adambujak/FALCON/README.md

FALCON

# An attempt at making drone
With Devin Bell ([@devinbellll](https://github.com/devinbellll) - Western University - Mechatronics Engineering) he's working on the flight controller, and I'm doing the RF, hardware, general bringup
