adambujak/FALCON/dependencies/gcc/README.md

# Config

Include GNU ARM toolchain (9-2020-q2-update version) in this folder, in subfolder ./gcc-arm-none-eabi-9-2020-q2-update
