adambujak/FALCON/hardware/pcb/hedwig/board.png

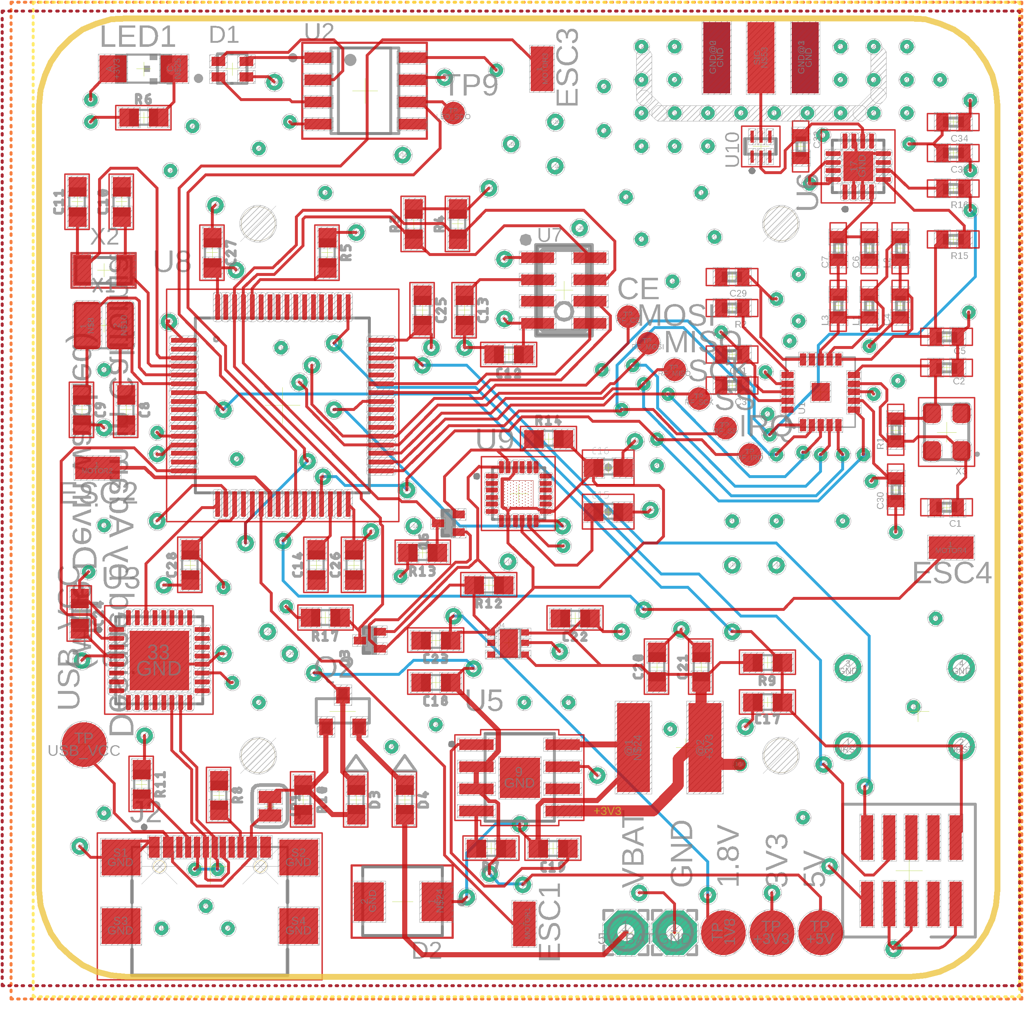
hardware/pcb/hedwig/board.png
