adambujak/FALCON/hardware/pcb/hedwig/board_bottom.png

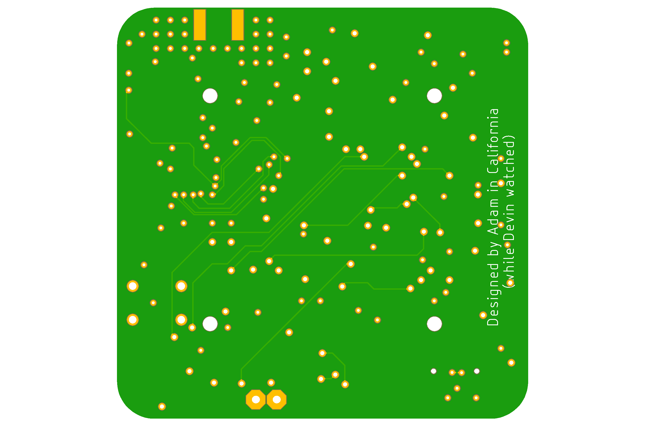
hardware/pcb/hedwig/board_bottom.png
