adambujak/FALCON/hardware/pcb/hedwig/board_top.png

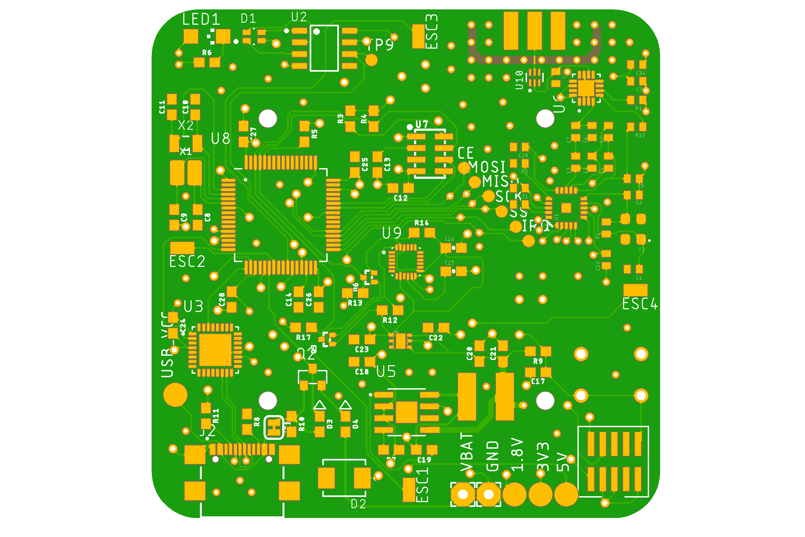
hardware/pcb/hedwig/board_top.png
