adambujak/FALCON/development/mechanicals/Part2.stl

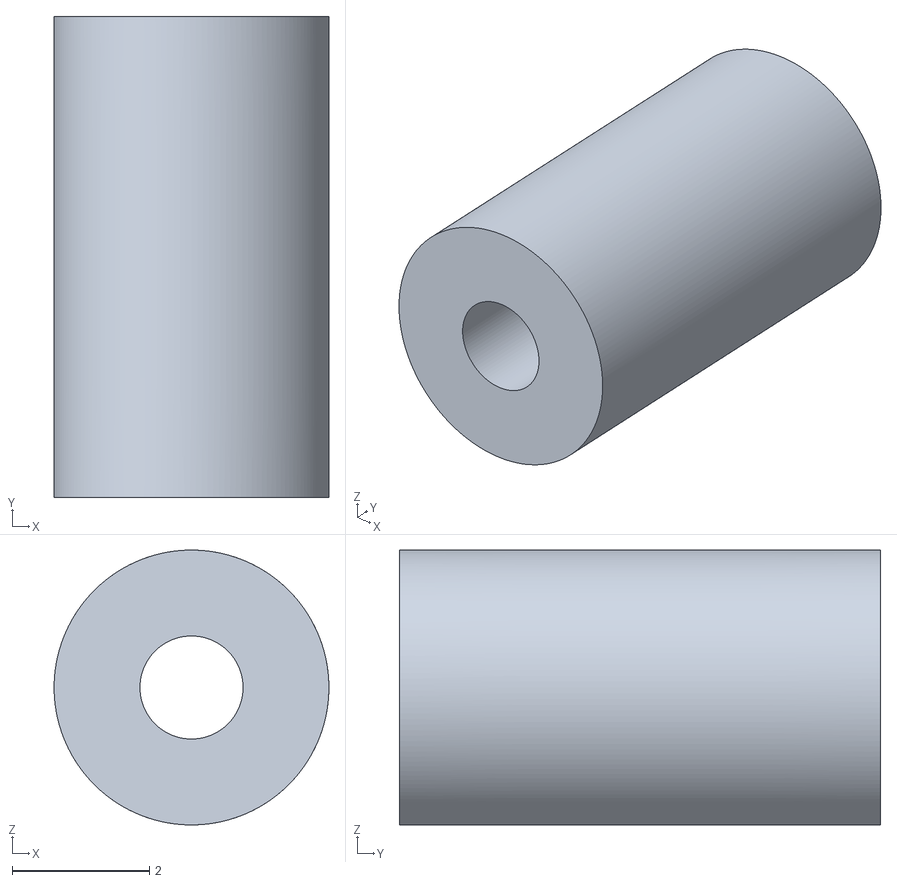
[picture p5: CAD file, 2020-04-04]
development/mechanicals/Part2.stl
4.00 x 7.00 x 4.00
