adambujak/FALCON/(list of files, cad)

Other CAD files:
development/mechanicals/motorconnector.ipt
development/mechanicals/motorholder-nocurvature.ipt
development/mechanicals/motorholder.ipt
