adambujak/FALCON/(threads)

Thread 59 (2021-04-18):

power supply browning out

adambujak, 2021-04-18:
radio failures due to power supply browning out

Thread 60 (2021-04-18):

python frame parsing

adambujak, 2021-04-18:
frame parsing doesn't work when serial monitor bufferflushcount is lowered.
either issue with how bytes are dropped in read thread or issue with frame parser

adambujak, 2021-04-20:
fixed

Closed 2021-04-20.

Thread 61 (2021-04-18):

flight control or sensor task starving device com

adambujak, 2021-04-18:
we start seeing tx failures from albus to hedwig when the flight control mode is set to 3

adambujak, 2021-04-19:
increasing device com priority does not solve issue

devinbellll, 2021-04-22:
what was the resolution to this issue?

adambujak, 2021-06-21:
I think this issue was due to higher current draw, and my 3.3V regulator not supplying it. But I'm not sure

devinbellll, 2022-11-22:
Please close out stale tickets with clear comments on how the issue was resolved

Thread 70 (2022-11-22):

Flight Control and Sensors Task starving eachother

adambujak, 2022-11-22:
If sensors task has higher priority, flight control task isn't executed with correct timing,
If flight control has higher priority, the `imu_get_data` function returns an error
