adambujak/FALCON/hardware/pcb/hedwig/hedwig.brd

## EAGLE design hardware/pcb/hedwig/hedwig.brd (2021-02-01)

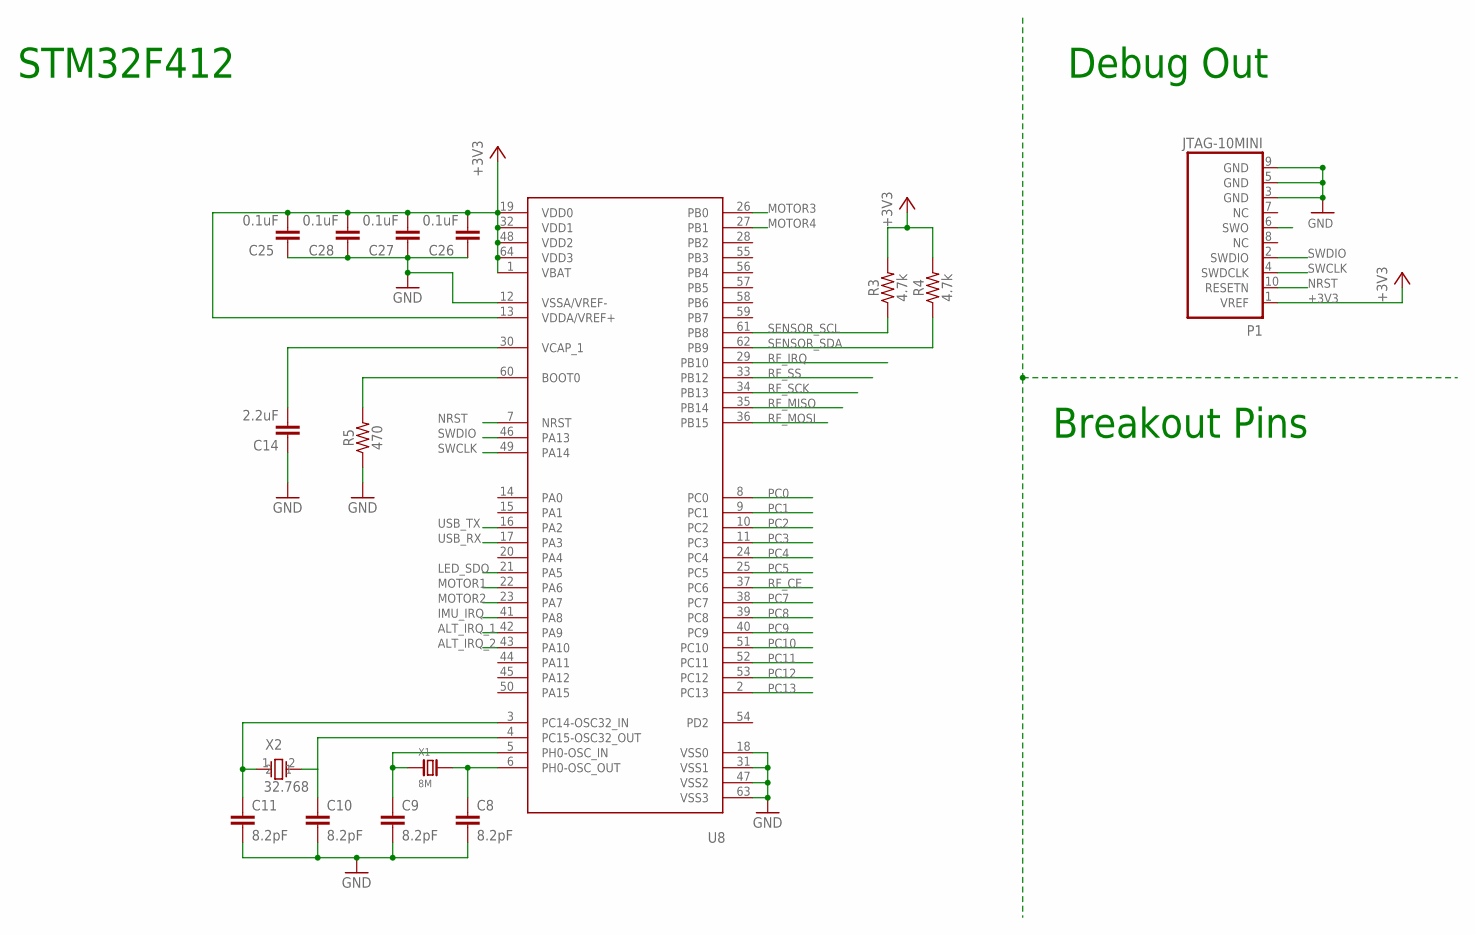
[picture p12: schematic hedwig.sch, sheet 1]

Parts:
C8, C9, C10, C11: 8.2pF; 0603
C14: 2.2uF; 0603
C25, C26, C27, C28: 0.1uF; 0603
P1: JTAG-10MINI
R3, R4: 4.7k; 0603
R5: 470; 0603
U8: STM32F412RE-S; QFP50P1200X1200X160-64N
X1: 8M; NDK-NX3225GD
X2: 32.768; NDK_NX3215SA-32.768K-STD-MUA-8_0

Connections:
+3V3: C25.2, C26.2, C27.2, C28.2, P1.1 (VREF), R3.2, R4.2, U8.1 (VBAT), U8.13 (VDDA/VREF+), U8.19 (VDD0), U8.32 (VDD1), U8.48 (VDD2), U8.64 (VDD3); also elsewhere on the board
ALT_IRQ_1: U8.42 (PA9); also elsewhere on the board
ALT_IRQ_2: U8.43 (PA10); also elsewhere on the board
GND: C8.2, C9.2, C10.2, C11.2, C14.1, C25.1, C26.1, C27.1, C28.1, P1.3 (GND), P1.5 (GND), P1.9 (GND), R5.1, U8.12 (VSSA/VREF-), U8.18 (VSS0), U8.31 (VSS1), U8.47 (VSS2), U8.63 (VSS3); also elsewhere on the board
IMU_IRQ: U8.41 (PA8); also elsewhere on the board
LED_SDO: U8.21 (PA5); also elsewhere on the board
MOTOR1: U8.22 (PA6); also elsewhere on the board
MOTOR2: U8.23 (PA7); also elsewhere on the board
MOTOR3: U8.26 (PB0); also elsewhere on the board
MOTOR4: U8.27 (PB1); also elsewhere on the board
unnamed: C9.1, U8.5 (PH0-OSC_IN), X1.1
unnamed: C8.1, U8.6 (PH0-OSC_OUT), X1.2
unnamed: C11.1, U8.3 (PC14-OSC32_IN), X2.1
unnamed: C10.1, U8.4 (PC15-OSC32_OUT), X2.2
unnamed: R5.2, U8.60 (BOOT0)
unnamed: C14.2, U8.30 (VCAP_1)
NRST: P1.10 (RESETN), U8.7 (NRST); also elsewhere on the board
PC0: U8.8 (PC0)
PC1: U8.9 (PC1)
PC2: U8.10 (PC2)
PC3: U8.11 (PC3)
PC4: U8.24 (PC4)
PC5: U8.25 (PC5)
PC7: U8.38 (PC7)
PC8: U8.39 (PC8)
PC9: U8.40 (PC9)
PC10: U8.51 (PC10)
PC11: U8.52 (PC11)
PC12: U8.53 (PC12)
PC13: U8.2 (PC13)
RF_CE: U8.37 (PC6); also elsewhere on the board
RF_IRQ: U8.29 (PB10); also elsewhere on the board
RF_MISO: U8.35 (PB14); also elsewhere on the board
RF_MOSI: U8.36 (PB15); also elsewhere on the board
RF_SCK: U8.34 (PB13); also elsewhere on the board
RF_SS: U8.33 (PB12); also elsewhere on the board
SENSOR_SCL: R3.1, U8.61 (PB8); also elsewhere on the board
SENSOR_SDA: R4.1, U8.62 (PB9); also elsewhere on the board
SWCLK: P1.4 (SWDCLK), U8.49 (PA14)
SWDIO: P1.2 (SWDIO), U8.46 (PA13)
USB_RX: U8.17 (PA3); also elsewhere on the board
USB_TX: U8.16 (PA2); also elsewhere on the board

Notes on the sheet:
Breakout Pins
STM32F412
Debug Out

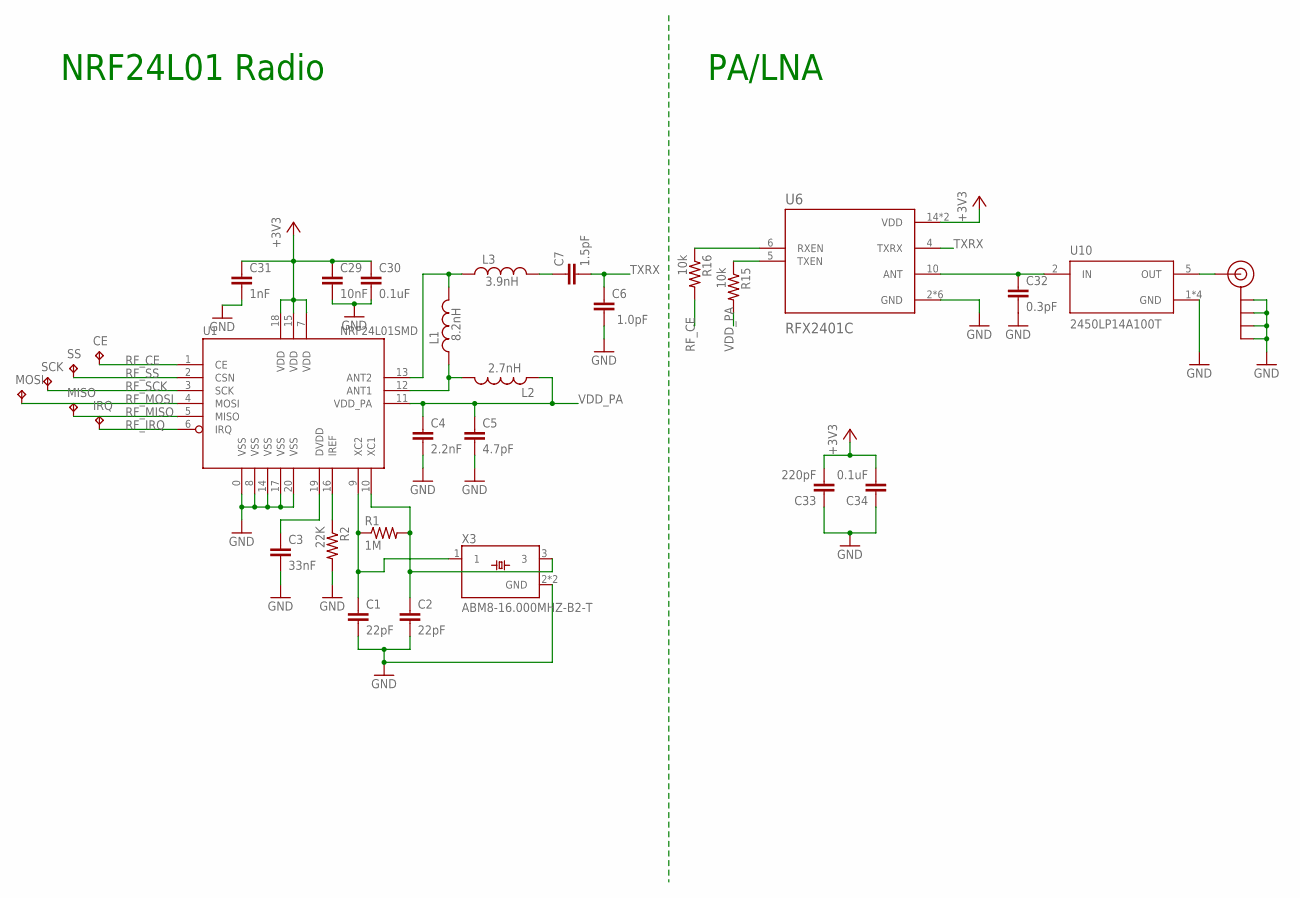
[picture p13: schematic hedwig.sch, sheet 2]

Parts:
C1, C2: 22pF; C0402
C3: 33nF; C0402
C4: 2.2nF; C0402
C5: 4.7pF; C0402
C6: 1.0pF; C0402
C7: 1.5pF; C0402
C29: 10nF; C0402
C30, C34: 0.1uF; C0402
C31: 1nF; C0402
C32: 0.3pF; C0402
C33: 220pF; C0402
CE: TPB1,27; B1,27
IRQ: TPB1,27; B1,27
J3: SMA_EDGE; SMA-EDGE
L1: 8.2nH; C0402
L2: 2.7nH; C0402
L3: 3.9nH; C0402
MISO: TPB1,27; B1,27
MOSI: TPB1,27; B1,27
R1: 1M; C0402
R2: 22K; C0402
R15, R16: 10k; C0402
SCK: TPB1,27; B1,27
SS: TPB1,27; B1,27
U1: NRF24L01SMD; QFN20
U6: RFX2401C; QFN50P300X300X60-17N
U10: 2450LP14A100T; ICCAF50P160X80X70-6N
X3: ABM8-16.000MHZ-B2-T; OSCSC320X250X100N

Connections:
+3V3: C29.1, C30.1, C31.1, C33.2, C34.2, U1.7 (VDD), U1.15 (VDD), U1.18 (VDD), U6.14 (VDD), U6.16 (VDD); also elsewhere on the board
GND: C1.2, C2.2, C3.2, C4.2, C5.2, C6.1, C29.2, C30.2, C31.2, C32.2, C33.1, C34.1, J3.GND@0 (GND), J3.GND@1 (GND), J3.GND@2 (GND), J3.GND@3 (GND), R2.2, U1.0 (VSS), U1.8 (VSS), U1.14 (VSS), U1.17 (VSS), U1.20 (VSS), U6.2 (GND), U6.3 (GND), U6.8 (GND), U6.9 (GND), U6.11 (GND), U6.17 (GND), U10.1 (GND), U10.3 (GND), U10.4 (GND), U10.6 (GND), X3.2 (GND), X3.4 (GND); also elsewhere on the board
unnamed: C1.1, R1.1, U1.9 (XC2), X3.1
unnamed: C2.1, R1.2, U1.10 (XC1), X3.3
unnamed: L1.1, L2.2, U1.12 (ANT1)
unnamed: R2.1, U1.16 (IREF)
unnamed: C3.1, U1.19 (DVDD)
unnamed: L1.2, L3.1, U1.13 (ANT2)
unnamed: C7.1, L3.2
unnamed: C32.1, U6.10 (ANT), U10.2 (IN)
unnamed: J3.SIG (SIGNAL), U10.5 (OUT)
unnamed: R16.1, U6.6 (RXEN)
unnamed: R15.1, U6.5 (TXEN)
RF_CE: CE.TP, R16.2, U1.1 (CE); also elsewhere on the board
RF_IRQ: IRQ.TP, U1.6 (IRQ); also elsewhere on the board
RF_MISO: MISO.TP, U1.5 (MISO); also elsewhere on the board
RF_MOSI: MOSI.TP, U1.4 (MOSI); also elsewhere on the board
RF_SCK: SCK.TP, U1.3 (SCK); also elsewhere on the board
RF_SS: SS.TP, U1.2 (CSN); also elsewhere on the board
TXRX: C6.2, C7.2, U6.4 (TXRX)
VDD_PA: C4.1, C5.1, L2.1, R15.2, U1.11 (VDD_PA)

Notes on the sheet:
NRF24L01 Radio
PA/LNA

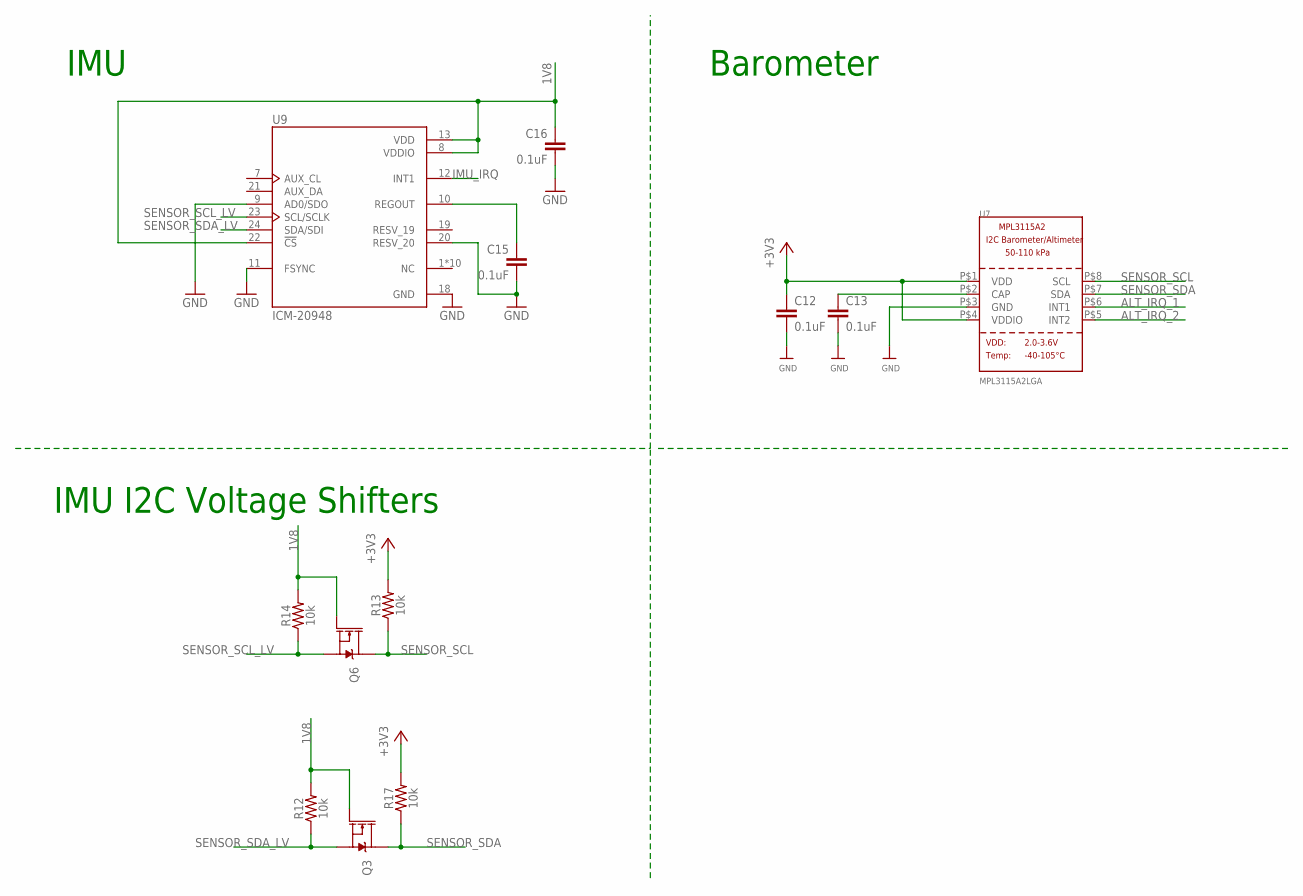
[picture p14: schematic hedwig.sch, sheet 3]

Parts:
C12, C13: 0.1uF; 0603
C15, C16: 0.1uF; 0603-CAP
Q3, Q6: 20V/0.2A/8MHz/1.2Ω/1Vth; SOT-416FL
R12, R13, R14, R17: 10k; 0603
U7: MPL3115A2LGA; LGA8
U9: ICM-20948; QFN40P300X300X105-24N

Connections:
1V8: C16.1, Q3.1 (G), Q6.1 (G), R12.2, R14.2, U9.8 (VDDIO), U9.13 (VDD), U9.22 (!CS); also elsewhere on the board
+3V3: C12.1, R13.2, R17.2, U7.P$1 (VDD), U7.P$4 (VDDIO); also elsewhere on the board
ALT_IRQ_1: U7.P$6 (INT1); also elsewhere on the board
ALT_IRQ_2: U7.P$5 (INT2); also elsewhere on the board
CAP: C13.1, U7.P$2 (CAP)
GND: C12.2, C13.2, C15.2, C16.2, U7.P$3 (GND), U9.9 (AD0/SDO), U9.11 (FSYNC), U9.18 (GND), U9.20 (RESV_20); also elsewhere on the board
IMU_IRQ: U9.12 (INT1); also elsewhere on the board
unnamed: C15.1, U9.10 (REGOUT)
SENSOR_SCL: Q6.3 (D), R13.1, U7.P$8 (SCL); also elsewhere on the board
SENSOR_SCL_LV: Q6.2 (S), R14.1, U9.23 (SCL/SCLK)
SENSOR_SDA: Q3.3 (D), R17.1, U7.P$7 (SDA); also elsewhere on the board
SENSOR_SDA_LV: Q3.2 (S), R12.1, U9.24 (SDA/SDI)

Notes on the sheet:
IMU
Barometer
IMU I2C Voltage Shifters

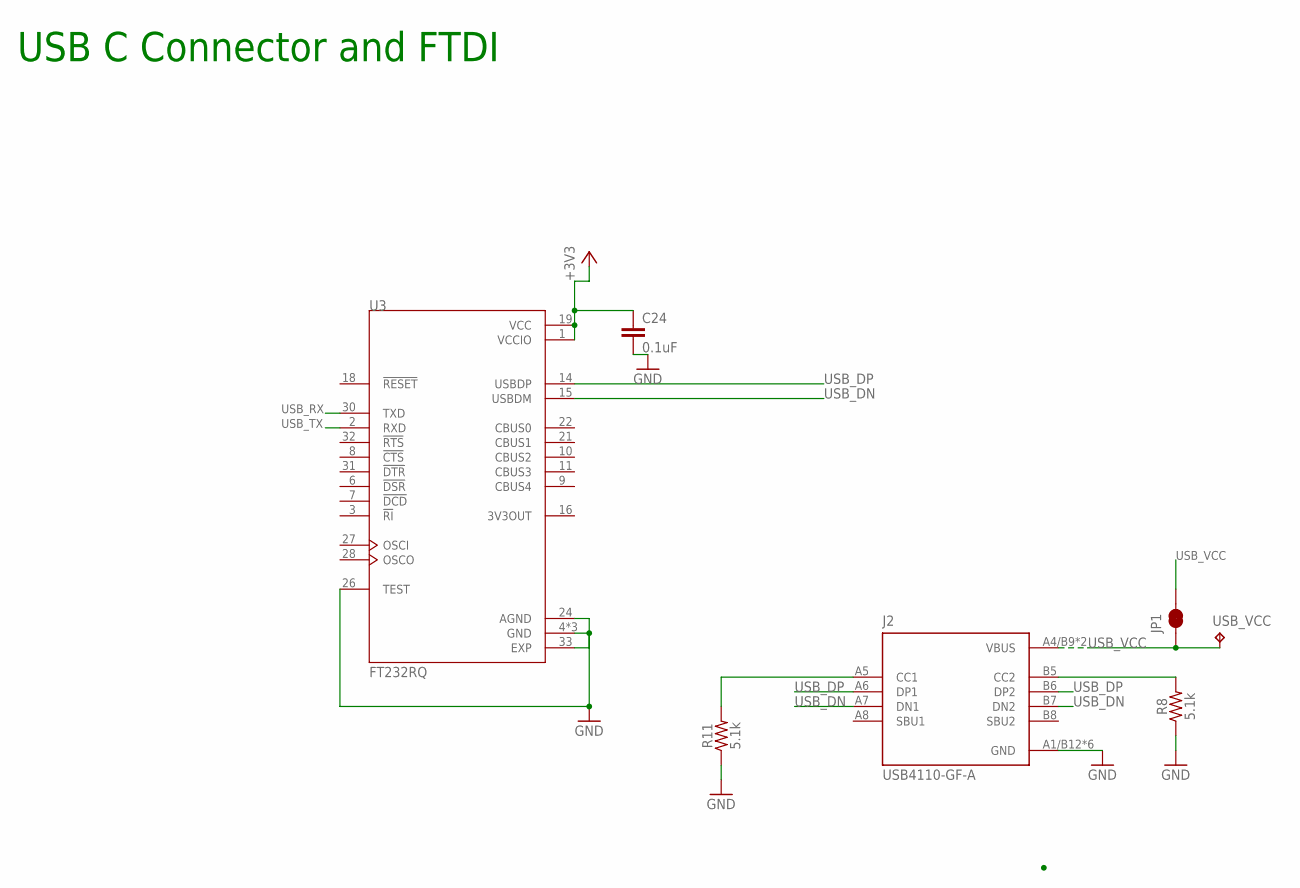
[picture p15: schematic hedwig.sch, sheet 4]

Parts:
C24: 0.1uF; 0603
J2: USB4110-GF-A; GCT_USB4110-GF-A
JP1: JUMPER-SMT_2_NC_TRACE_SILK; SMT-JUMPER_2_NC_TRACE_SILK
R8, R11: 5.1k; 0603
U3: FT232RQ; QFN50P500X500X90-33N
USB_VCC: TPB2,54; B2,54

Connections:
+3V3: C24.1, U3.1 (VCCIO), U3.19 (VCC); also elsewhere on the board
GND: C24.2, J2.A1/B12 (GND), J2.B1/A12 (GND), J2.S1 (GND), J2.S2 (GND), J2.S3 (GND), J2.S4 (GND), R8.1, R11.1, U3.4 (GND), U3.17 (GND), U3.20 (GND), U3.24 (AGND), U3.26 (TEST), U3.33 (EXP); also elsewhere on the board
unnamed: J2.B5 (CC2), R8.2
unnamed: J2.A5 (CC1), R11.2
USB_DN: J2.A7 (DN1), J2.B7 (DN2), U3.15 (USBDM)
USB_DP: J2.A6 (DP1), J2.B6 (DP2), U3.14 (USBDP)
USB_RX: U3.30 (TXD); also elsewhere on the board
USB_TX: U3.2 (RXD); also elsewhere on the board
USB_VCC: J2.A4/B9 (VBUS), J2.B4/A9 (VBUS), JP1.1, JP1.2, USB_VCC.TP; also elsewhere on the board

Notes on the sheet:
USB C Connector and FTDI

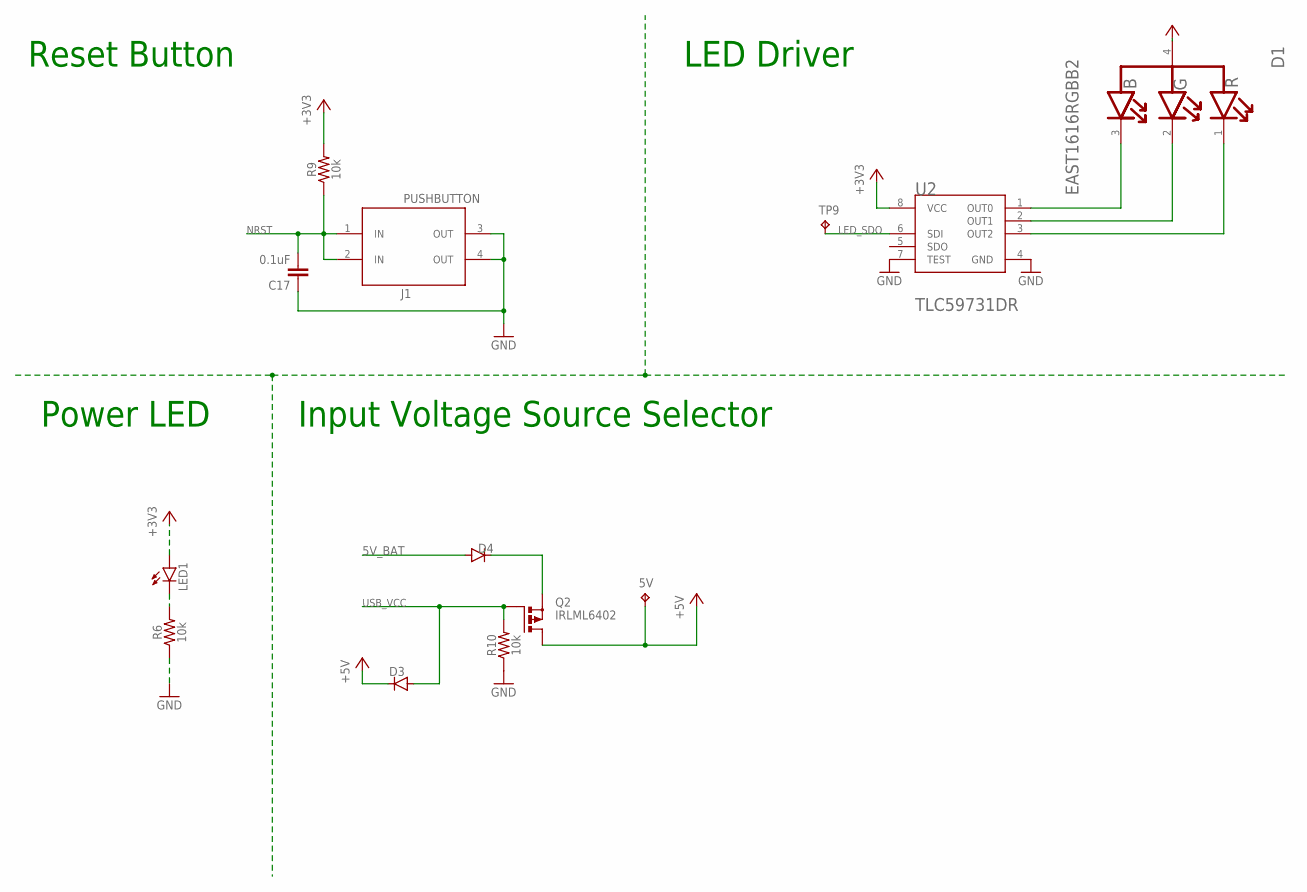
[picture p16: schematic hedwig.sch, sheet 5]

Parts:
5V: TPB2,54; B2,54
C17: 0.1uF; 0603
D1: EVERLIGHT_EAST1616RGBB2EVERLIGHT_EAST1616RGBB2_0_0; EVERLIGHT_EAST1616RGBB2_0
D3, D4: DIODE_0603
J1: PUSHBUTTON; PUSH_BUTTON
LED1: LEDCHIPLED_1206; CHIPLED_1206
Q2: IRLML6402; SOT-23
R6, R9, R10: 10k; 0603
TP9: TPB1,27; B1,27
U2: TEXAS_INSTRUMENTS_TLC59731DRTEXAS_INSTRUMENTS_TLC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; TEXAS_INSTRUMENTS_TLC59731DR_0

Connections:
5V_BAT: D4.A; also elsewhere on the board
+3V3: D1.4 (COMMON_ANODE), LED1.A, R9.2, U2.8 (VCC); also elsewhere on the board
+5V: 5V.TP, D3.C, Q2.P3 (D); also elsewhere on the board
GND: C17.1, J1.3 (OUT), J1.4 (OUT), R6.1, R10.1, U2.4 (GND), U2.7 (TEST); also elsewhere on the board
LED_SDO: TP9.TP, U2.6 (SDI); also elsewhere on the board
unnamed: D1.1 (RED_CATHODE), U2.3 (OUT2)
unnamed: D1.3 (BLUE_CATHODE), U2.1 (OUT0)
unnamed: LED1.C, R6.2
unnamed: D1.2 (GREEN_CATHODE), U2.2 (OUT1)
unnamed: D4.C, Q2.P2 (S)
NRST: C17.2, J1.1 (IN), J1.2 (IN), R9.1; also elsewhere on the board
USB_VCC: D3.A, Q2.P1 (G), R10.2; also elsewhere on the board

Notes on the sheet:
Reset Button
LED Driver
Power LED
Input Voltage Source Selector

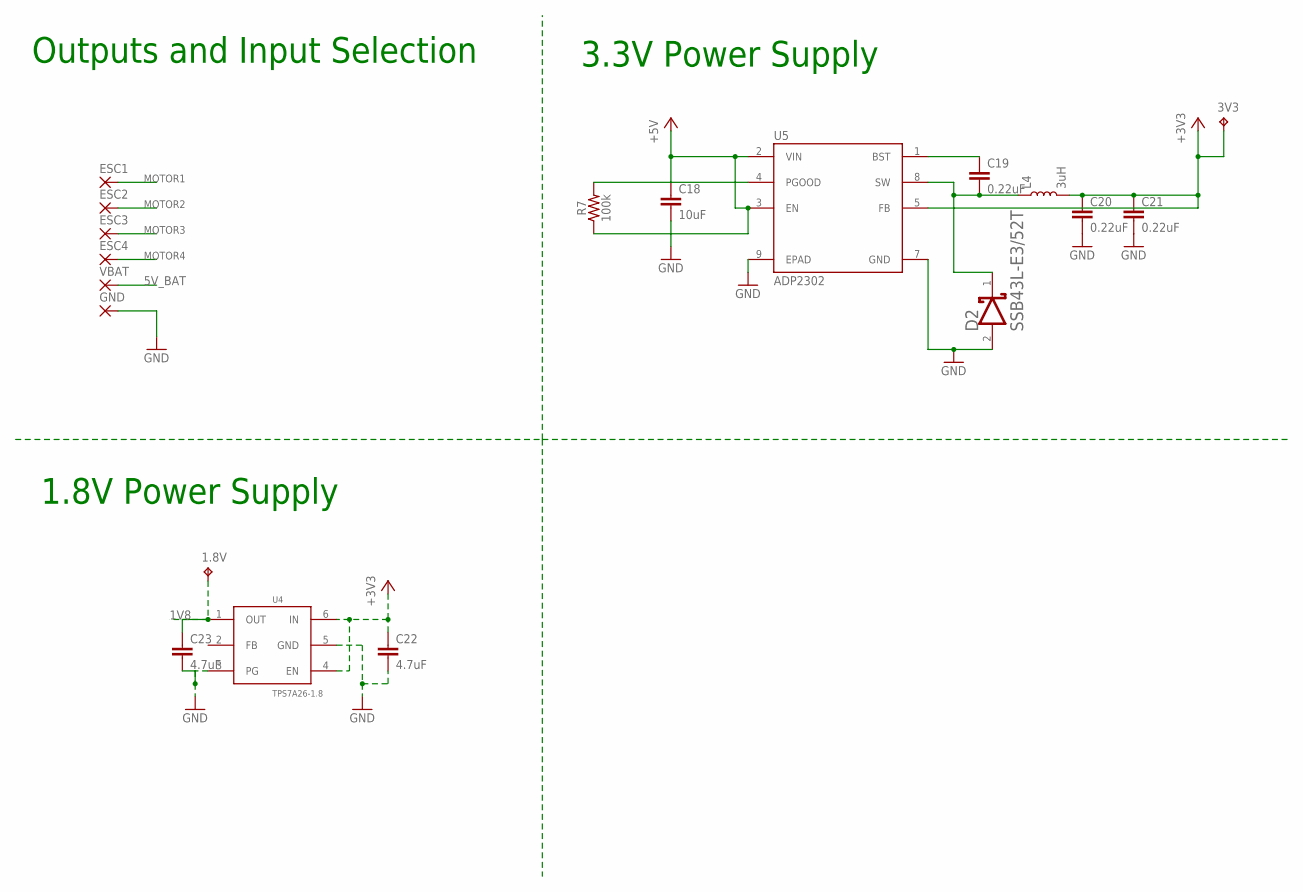
[picture p17: schematic hedwig.sch, sheet 6]

Parts:
1.8V, 3V3: TPB2,54; B2,54
C18: 10uF; 0603
C19, C20, C21: 0.22uF; 0603
C22, C23: 4.7uF; 0603
D2: SSB43L; VISHAY_SSB43L-E3-52T_0
ESC1, ESC2, ESC3, ESC4: SMD2; SMD1,27-2,54
GND: 2,54/1,0
L4: 3uH; REG_INDUCTOR
R7: 100k; 0603
U4: TPS7A26-1.8; WSON
U5: ADP2302; SOIC127P600X175-9N
VBAT: 2,54/1,0

Connections:
1V8: 1.8V.TP, C23.1, U4.1 (OUT); also elsewhere on the board
5V_BAT: VBAT.1; also elsewhere on the board
+3V3: 3V3.TP, C20.1, C21.1, C22.1, L4.@2 (2), U4.4 (EN), U4.6 (IN), U5.5 (FB); also elsewhere on the board
+5V: C18.1, R7.1, U5.2 (VIN), U5.3 (EN); also elsewhere on the board
GND: C18.2, C20.2, C21.2, C22.2, C23.2, D2.2 (ANODE), GND.1, U4.3 (PG), U4.5 (GND), U5.7 (GND), U5.9 (EPAD); also elsewhere on the board
MOTOR1: ESC1.1; also elsewhere on the board
MOTOR2: ESC2.1; also elsewhere on the board
MOTOR3: ESC3.1; also elsewhere on the board
MOTOR4: ESC4.1; also elsewhere on the board
unnamed: C19.1, U5.1 (BST)
unnamed: R7.2, U5.4 (PGOOD)
unnamed: C19.2, D2.1 (CATHODE), L4.@1 (1), U5.8 (SW)

Notes on the sheet:
Outputs and Input Selection
3.3V Power Supply
1.8V Power Supply

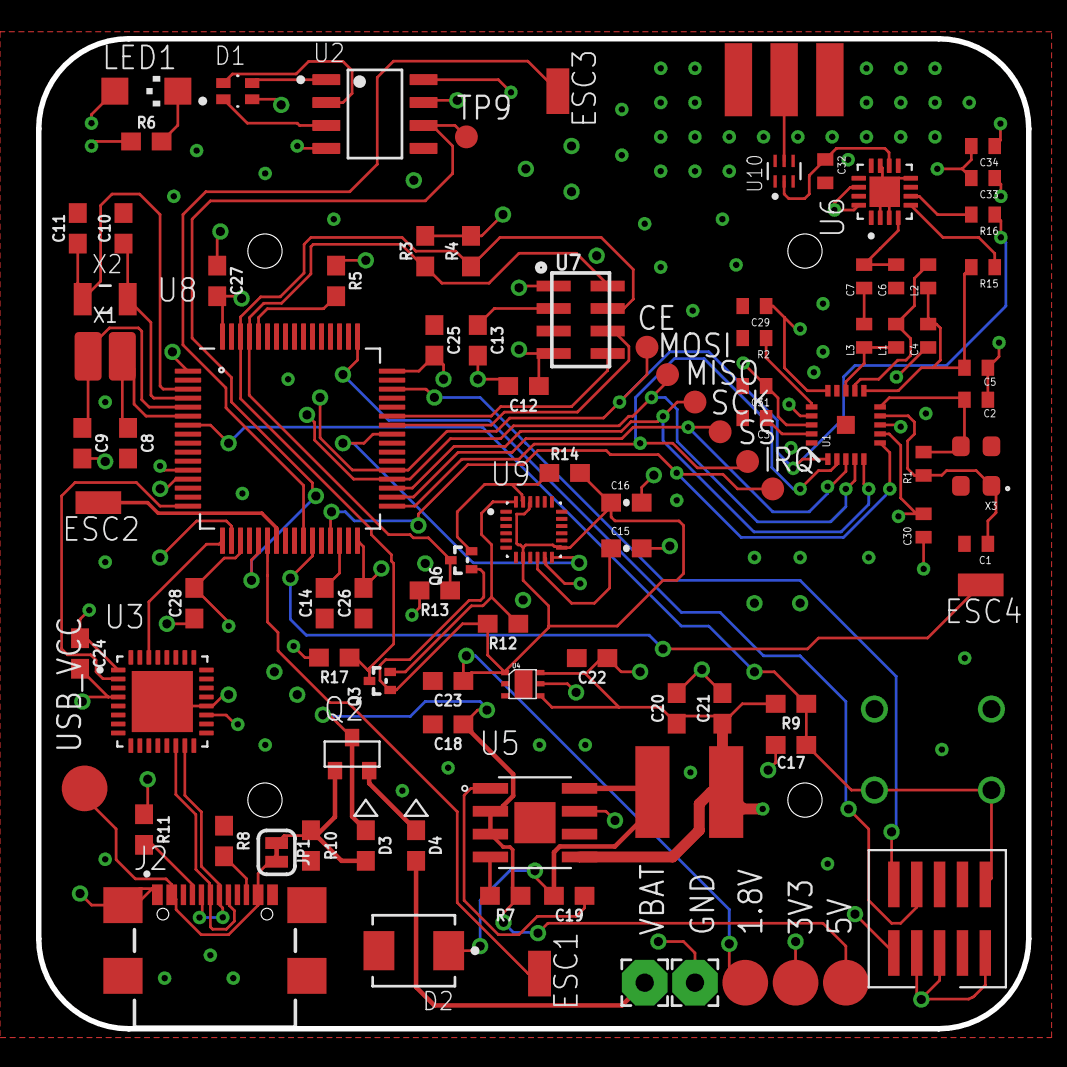
[picture p18: board hedwig.brd from above]

Board: 4 copper layers, 55.0 x 55.0 mm, 98 parts (0 on the bottom side), 62 nets.
