adambujak/FALCON/development/drivers/ICM20948/driver/inv_mems_defines.h

#define _INV_MEMS_DEFINES_H_
#include <string.h>
#include <stdlib.h>
#include "common/mltypes.h"
#include "common/inv_mems_drv_hook.h"
#if defined MEMS_20630
#include "dmp3/dmp3Driver.h"
#elif defined MEMS_30630
#include "dmp3/dmp3Driver.h"
#elif defined MEMS_20645E
#include "dmp3/dmp3Driver.h"
#elif defined MEMS_20648
#include "dmp3a/dmp3Driver.h"
#elif defined MEMS_20609
#include "dmp3a/dmp3Driver.h"
#else
#error "Unsupported configuration"
#endif
#ifdef __cplusplus
extern "C" {
#endif
#define MPU_SUCCESS (0)
#define MPU_COMPASS_NOT_FOUND (int)0x00ABCDEF
#define MSEC_PER_SEC 1000
#define NSEC_PER_MSEC 1000000
#define NSEC_PER_SEC NSEC_PER_MSEC * MSEC_PER_SEC
#define FIFO_DIVIDER 10
#if defined MEMS_20648
#define REG_BANK_0 0x00
#define REG_BANK_1 0x01
#define DIAMOND_I2C_ADDRESS     0x68
#define BANK_0                  (0 << 7)
#define BANK_1                  (1 << 7)
#define BANK_2                  (2 << 7)
#define BANK_3                  (3 << 7)
#define REG_WHO_AM_I            (BANK_0 | 0x00)
#define REG_LPF                 (BANK_0 | 0x01)
#define REG_USER_CTRL           (BANK_0 | 0x03)
#define BIT_DMP_EN                      0x80
#define BIT_FIFO_EN                     0x40
#define BIT_I2C_MST_EN                  0x20
#define BIT_I2C_IF_DIS                  0x10
#define BIT_DMP_RST                     0x08
#define BIT_DIAMOND_DMP_RST			    0x04
#define REG_LP_CONFIG           (BANK_0 | 0x05)
#define BIT_I2C_MST_CYCLE               0x40
#define BIT_ACCEL_CYCLE                 0x20
#define BIT_GYRO_CYCLE                  0x10
#define REG_PWR_MGMT_1          (BANK_0 | 0x06)
#define BIT_H_RESET                     0x80
#define BIT_SLEEP                       0x40
#define BIT_LP_EN                       0x20
#define BIT_CLK_PLL                     0x01
#define REG_PWR_MGMT_2          (BANK_0 | 0x07)
#define BIT_PWR_PRESSURE_STBY           0x40
#define BIT_PWR_ACCEL_STBY              0x38
#define BIT_PWR_GYRO_STBY               0x07
#define BIT_PWR_ALL_OFF                 0x7f
#define REG_INT_PIN_CFG         (BANK_0 | 0x0F)
#define BIT_INT_LATCH_EN                0x20
#define BIT_BYPASS_EN                   0x02
#define REG_INT_ENABLE          (BANK_0 | 0x10)
#define BIT_DMP_INT_EN                  0x02
#define REG_INT_ENABLE_1        (BANK_0 | 0x11)
#define BIT_DATA_RDY_3_EN               0x08
#define BIT_DATA_RDY_2_EN               0x04
#define BIT_DATA_RDY_1_EN               0x02
#define BIT_DATA_RDY_0_EN               0x01
#define REG_INT_ENABLE_2        (BANK_0 | 0x12)
#define BIT_FIFO_OVERFLOW_EN_0          0x1
#define REG_INT_ENABLE_3        (BANK_0 | 0x13)
#define REG_DMP_INT_STATUS      (BANK_0 | 0x18)
#define BIT_WAKE_ON_MOTION_INT          0x08
#define BIT_MSG_DMP_INT                 0x0002
#define BIT_MSG_DMP_INT_0               0x0100  // CI Command
#if (MEMS_CHIP == HW_ICM20648)
#define BIT_MSG_DMP_INT_2               0x0200  // CIM Command - SMD
#define BIT_MSG_DMP_INT_3               0x0400  // CIM Command - Pedometer
#else
#define BIT_MSG_DMP_INT_2               0x0400  // CIM Command - SMD
#define BIT_MSG_DMP_INT_3               0x0800  // CIM Command - Pedometer
#endif
#define BIT_MSG_DMP_INT_4               0x1000  // CIM Command - Pedometer binning
#define BIT_MSG_DMP_INT_5               0x2000  // CIM Command - Bring To See Gesture
#define BIT_MSG_DMP_INT_6               0x4000  // CIM Command - Look To See Gesture
#define REG_INT_STATUS          (BANK_0 | 0x19)
#define BIT_DMP_INT                     0x02
#define REG_INT_STATUS_1        (BANK_0 | 0x1A)
#define REG_INT_STATUS_2        (BANK_0 | 0x1B)
#define REG_SINGLE_FIFO_PRIORITY_SEL        (BANK_0 | 0x26)
#define REG_GYRO_XOUT_H_SH      (BANK_0 | 0x33)
#define REG_TEMPERATURE         (BANK_0 | 0x39)
#define REG_TEMP_CONFIG         (BANK_0 | 0x53)
#define REG_EXT_SLV_SENS_DATA_00 (BANK_0 | 0x3B)
#define REG_EXT_SLV_SENS_DATA_08 (BANK_0 | 0x43)
#define REG_EXT_SLV_SENS_DATA_09 (BANK_0 | 0x44)
#define REG_EXT_SLV_SENS_DATA_10 (BANK_0 | 0x45)
#define REG_FIFO_EN             (BANK_0 | 0x66)
#define BIT_SLV_0_FIFO_EN               0x01
#define REG_FIFO_EN_2           (BANK_0 | 0x67)
#define BIT_PRS_FIFO_EN                 0x20
#define BIT_ACCEL_FIFO_EN               0x10
#define BITS_GYRO_FIFO_EN               0x0E
#define REG_FIFO_RST            (BANK_0 | 0x68)
#define REG_FIFO_COUNT_H        (BANK_0 | 0x70)
#define REG_FIFO_R_W            (BANK_0 | 0x72)
#define REG_HW_FIX_DISABLE      (BANK_0 | 0x75)
#define REG_FIFO_CFG            (BANK_0 | 0x76)
#define BIT_MULTI_FIFO_CFG              0x01
#define BIT_SINGLE_FIFO_CFG             0x00
#define REG_ACCEL_XOUT_H_SH     (BANK_0 | 0x2D)
#define REG_ACCEL_XOUT_L_SH     (BANK_0 | 0x2E)
#define REG_ACCEL_YOUT_H_SH     (BANK_0 | 0x2F)
#define REG_ACCEL_YOUT_L_SH     (BANK_0 | 0x30)
#define REG_ACCEL_ZOUT_H_SH     (BANK_0 | 0x31)
#define REG_ACCEL_ZOUT_L_SH     (BANK_0 | 0x32)
#define REG_MEM_START_ADDR      (BANK_0 | 0x7C)
#define REG_MEM_R_W             (BANK_0 | 0x7D)
#define REG_MEM_BANK_SEL        (BANK_0 | 0x7E)
#define REG_XA_OFFS_H                 (BANK_1 | 0x14)
#define REG_YA_OFFS_H                 (BANK_1 | 0x17)
#define REG_ZA_OFFS_H                 (BANK_1 | 0x1A)
#define REG_TIMEBASE_CORRECTION_PLL   (BANK_1 | 0x28)
#define REG_TIMEBASE_CORRECTION_RCOSC (BANK_1 | 0x29)
#define REG_SELF_TEST1                (BANK_1 | 0x02)
#define REG_SELF_TEST2                (BANK_1 | 0x03)
#define REG_SELF_TEST3                (BANK_1 | 0x04)
#define REG_SELF_TEST4                (BANK_1 | 0x0E)
#define REG_SELF_TEST5                (BANK_1 | 0x0F)
#define REG_SELF_TEST6                (BANK_1 | 0x10)
#define REG_GYRO_SMPLRT_DIV     (BANK_2 | 0x00)
#define REG_GYRO_CONFIG_1       (BANK_2 | 0x01)
#define SHIFT_GYRO_FS_SEL               1
#define SHIFT_GYRO_DLPCFG               3
#define REG_GYRO_CONFIG_2       (BANK_2 | 0x02)
#define BIT_GYRO_CTEN                   0x38
#define REG_XG_OFFS_USR_H       (BANK_2 | 0x03)
#define REG_YG_OFFS_USR_H       (BANK_2 | 0x05)
#define REG_ZG_OFFS_USR_H       (BANK_2 | 0x07)
#define REG_ACCEL_SMPLRT_DIV_1  (BANK_2 | 0x10)
#define REG_ACCEL_SMPLRT_DIV_2  (BANK_2 | 0x11)
#define REG_ACCEL_CONFIG        (BANK_2 | 0x14)
#define SHIFT_ACCEL_FS                  1
#define REG_ACCEL_CONFIG_2      (BANK_2 | 0x15)
#define BIT_ACCEL_CTEN                  0x1C
#define REG_PRS_ODR_CONFIG      (BANK_2 | 0x20)
#define REG_PRGM_START_ADDRH    (BANK_2 | 0x50)
#define REG_MOD_CTRL_USR        (BANK_2 | 0x54)
#define BIT_ODR_SYNC                    0x7
#define REG_I2C_MST_ODR_CONFIG  (BANK_3 | 0x0)
#define REG_I2C_MST_CTRL        (BANK_3 | 0x01)
#define BIT_I2C_MST_P_NSR               0x10
#define REG_I2C_MST_DELAY_CTRL  (BANK_3 | 0x02)
#define BIT_SLV0_DLY_EN                 0x01
#define BIT_SLV1_DLY_EN                 0x02
#define BIT_SLV2_DLY_EN                 0x04
#define BIT_SLV3_DLY_EN                 0x08
#define BIT_DELAY_ES_SHADOW             0x80
#define REG_I2C_SLV0_ADDR       (BANK_3 | 0x03)
#define REG_I2C_SLV0_REG        (BANK_3 | 0x04)
#define REG_I2C_SLV0_CTRL       (BANK_3 | 0x05)
#define REG_I2C_SLV0_DO         (BANK_3 | 0x06)
#define REG_I2C_SLV1_ADDR       (BANK_3 | 0x07)
#define REG_I2C_SLV1_REG        (BANK_3 | 0x08)
#define REG_I2C_SLV1_CTRL       (BANK_3 | 0x09)
#define REG_I2C_SLV1_DO         (BANK_3 | 0x0A)
#define REG_I2C_SLV2_ADDR       (BANK_3 | 0x0B)
#define REG_I2C_SLV2_REG        (BANK_3 | 0x0C)
#define REG_I2C_SLV2_CTRL       (BANK_3 | 0x0D)
#define REG_I2C_SLV2_DO         (BANK_3 | 0x0E)
#define REG_I2C_SLV3_ADDR       (BANK_3 | 0x0F)
#define REG_I2C_SLV3_REG        (BANK_3 | 0x10)
#define REG_I2C_SLV3_CTRL       (BANK_3 | 0x11)
#define REG_I2C_SLV3_DO         (BANK_3 | 0x12)
#define REG_I2C_SLV4_CTRL       (BANK_3 | 0x15)
#define INV_MPU_BIT_SLV_EN      0x80
#define INV_MPU_BIT_BYTE_SW     0x40
#define INV_MPU_BIT_REG_DIS     0x20
#define INV_MPU_BIT_GRP         0x10
#define INV_MPU_BIT_I2C_READ    0x80
#define REG_BANK_SEL            0x7F
#define BYTES_PER_SENSOR         6
#define FIFO_COUNT_BYTE          2
#define HARDWARE_FIFO_SIZE       1024
#define FIFO_SIZE                (HARDWARE_FIFO_SIZE * 4 / 5)
#define POWER_UP_TIME            100
#define REG_UP_TIME_USEC         100
#define DMP_RESET_TIME           20
#define GYRO_ENGINE_UP_TIME      50
#define MPU_MEM_BANK_SIZE        256
#define IIO_BUFFER_BYTES         8
#define HEADERED_NORMAL_BYTES    8
#define HEADERED_Q_BYTES         16
#define LEFT_OVER_BYTES          128
#define BASE_SAMPLE_RATE         1125
#ifdef FREQ_225
#define MPU_DEFAULT_DMP_FREQ     225
#define PEDOMETER_FREQ           (MPU_DEFAULT_DMP_FREQ >> 2)
#define DEFAULT_ACCEL_GAIN       (33554432L * 5 / 11)
#else
#define MPU_DEFAULT_DMP_FREQ     102
#define PEDOMETER_FREQ           (MPU_DEFAULT_DMP_FREQ >> 1)
#define DEFAULT_ACCEL_GAIN       33554432L
#endif
#define PED_ACCEL_GAIN           67108864L
#define ALPHA_FILL_PED           858993459
#define A_FILL_PED               214748365
#define MIN_MST_ODR_CONFIG       4
#define THREE_AXES               3
#define NINE_ELEM                (THREE_AXES * THREE_AXES)
#define MPU_TEMP_SHIFT           16
#define SOFT_IRON_MATRIX_SIZE    (4 * 9)
#define DMP_DIVIDER              (BASE_SAMPLE_RATE / MPU_DEFAULT_DMP_FREQ)
#define MAX_5_BIT_VALUE          0x1F
#define BAD_COMPASS_DATA         0x7FFF
#define DEFAULT_BATCH_RATE       400
#define DEFAULT_BATCH_TIME    (MSEC_PER_SEC / DEFAULT_BATCH_RATE)
#define MAX_COMPASS_RATE         115
#define MAX_PRESSURE_RATE        30
#define MAX_ALS_RATE             5
#define DATA_AKM_99_BYTES_DMP  10
#define DATA_AKM_89_BYTES_DMP  9
#define DATA_ALS_BYTES_DMP     8
#define APDS9900_AILTL_REG      0x04
#define BMP280_DIG_T1_LSB_REG                0x88
#define COVARIANCE_SIZE          14
#define ACCEL_COVARIANCE_SIZE  (COVARIANCE_SIZE * sizeof(int))
#define COMPASS_COVARIANCE_SIZE  (COVARIANCE_SIZE * sizeof(int))
#define TEMPERATURE_SCALE  3340827L
#define TEMPERATURE_OFFSET 1376256L
#define SECONDARY_INIT_WAIT 60
#define MPU_SOFT_UPDT_ADDR               0x86
#define MPU_SOFT_UPTD_MASK               0x0F
#define AK99XX_SHIFT                    23
#define AK89XX_SHIFT                    22
#define OPERATE_GYRO_IN_DUTY_CYCLED_MODE       (1<<4)
#define OPERATE_ACCEL_IN_DUTY_CYCLED_MODE      (1<<5)
#define OPERATE_I2C_MASTER_IN_DUTY_CYCLED_MODE (1<<6)
#define PED_BAC_RATE_HZ 56 // expected rate by BAC in DMP (Hz)
#endif
#if defined MEMS_20609
#define REG_BANK_SEL            0x7F
#define REG_XA_OFFS_H		0x77
#define REG_YA_OFFS_H		0x7A
#define REG_ZA_OFFS_H           0x7D
#define REG_XA_OFFS_L_TC        0x7
#define REG_PRODUCT_ID          0xC
#define REG_ST_GCT_X            0xD
#define REG_XG_OFFS_USR_H        0x13
#define REG_YG_OFFS_USR_H        0x15
#define REG_ZG_OFFS_USR_H        0x17
#define REG_SAMPLE_RATE_DIV     0x19
#define REG_CONFIG              0x1A
#define EXT_SYNC_SET                      8
#define REG_GYRO_CONFIG		0x1B
#define BITS_SELF_TEST_EN		0xE0
#define SHIFT_GYRO_FS_SEL		0x03
#define REG_ACCEL_CONFIG		0x1C
#define SHIFT_ACCEL_FS			0x03
#define REG_ACCEL_MOT_THR       0x1F
#define REG_ACCEL_MOT_DUR       0x20
#define REG_ACCEL_CONFIG_2  0x1D
#define BIT_ACCEL_FCHOCIE_B              0x08
#define REG_FIFO_EN		0x23
#define BITS_TEMP_FIFO_EN                   0x80
#define BITS_GYRO_FIFO_EN		    0x70
#define BIT_ACCEL_FIFO_EN	            0x08
#define BIT_SLV_0_FIFO_EN                   0x01
#define REG_I2C_SLV0_ADDR       0x25
#define REG_I2C_SLV0_REG        0x26
#define REG_I2C_SLV0_CTRL       0x27
#define REG_I2C_SLV1_ADDR       0x28
#define REG_I2C_SLV1_REG        0x29
#define REG_I2C_SLV1_CTRL       0x2A
#define REG_I2C_SLV2_ADDR       0x2B
#define REG_I2C_SLV2_REG        0x2C
#define REG_I2C_SLV2_CTRL       0x2D
#define REG_I2C_SLV4_CTRL       0x34
#define REG_FSYNC_INT		0x36
#define BIT_FSYNC_INT                   0x80
#define REG_INT_PIN_CFG		0x37
#define BIT_BYPASS_EN		0x2
#define REG_INT_ENABLE		0x38
#define BIT_WOM_INT_EN		        0xe0
#define BIT_FIFO_OFLOW_EN	        0x10
#define BIT_FSYNC_INT_EN	        0x8
#define BIT_DMP_INT_EN		        0x02
#define BIT_DATA_RDY_EN		        0x01
#define REG_DMP_INT_STATUS      0x39
#define BIT_MSG_DMP_INT                 0x0002
#define BIT_MSG_DMP_INT_2               0x0400  // CIM Command - SMD
#define BIT_MSG_DMP_INT_3               0x0800  // CIM Command - Pedometer
#define REG_INT_STATUS          0x3A
#define BIT_WOM_INT                    0xE0
#define REG_RAW_ACCEL           0x3B
#define REG_EXT_SLV_SENS_DATA_00         0x49
#define REG_ACCEL_INTEL_STATUS  0x61
#define REG_I2C_SLV0_DO          0x63
#define REG_I2C_SLV1_DO          0x64
#define REG_I2C_SLV2_DO          0x65
#define REG_I2C_MST_DELAY_CTRL   0x67
#define BIT_I2C_SLV1_DELAY_EN                   0x02
#define BIT_I2C_SLV0_DELAY_EN                   0x01
#define REG_USER_CTRL            0x6A
#define BIT_COND_RST				0x01
#define BIT_FIFO_RST				0x04
#define BIT_DMP_RST				0x08
#define BIT_I2C_IF_DIS				0x10
#define BIT_I2C_MST_EN                          0x20
#define BIT_FIFO_EN				0x40
#define BIT_DMP_EN				0x80
#define REG_PWR_MGMT_1	         0x6B
#define BIT_H_RESET				0x80
#define BIT_SLEEP				0x40
#define BIT_LP_EN                       	0x20
#define BIT_CLK_PLL				0x01
#define BIT_CLK_MASK				0x07
#define REG_PWR_MGMT_2			0x6C
#define BIT_PWR_ACCEL_STBY		0x38
#define BIT_PWR_GYRO_STBY		0x07
#define BIT_PWR_ALL_OFF			0x3F
#define REG_MEM_BANK_SEL		0x6D
#define REG_MEM_START_ADDR	0x6E
#define REG_MEM_R_W				0x6F
#define REG_PRGM_START_ADDRH	0x70
#define REG_FIFO_COUNT_H        0x72
#define REG_FIFO_R_W            0x74
#define REG_WHO_AM_I              0x75
#define REG_6500_XG_ST_DATA     0x0
#define REG_6500_XA_ST_DATA     0xD
#define REG_6500_XA_OFFS_H      0x77
#define REG_6500_YA_OFFS_H      0x7A
#define REG_6500_ZA_OFFS_H      0x7D
#define REG_6500_ACCEL_CONFIG2  0x1D
#define BIT_ACCEL_FCHOCIE_B              0x08
#define BIT_FIFO_SIZE_1K                 0x40
#define REG_LP_MODE_CFG		0x1E
#define REG_6500_LP_ACCEL_ODR   0x1E
#define REG_6500_ACCEL_WOM_THR  0x1F
#define REG_SELF_TEST1                0x00
#define REG_SELF_TEST2                0x01
#define REG_SELF_TEST3                0x02
#define REG_SELF_TEST4                0x0D
#define REG_SELF_TEST5                0x0E
#define REG_SELF_TEST6                0x0F
#define INV_MPU_BIT_SLV_EN      0x80
#define INV_MPU_BIT_BYTE_SW     0x40
#define INV_MPU_BIT_REG_DIS     0x20
#define INV_MPU_BIT_GRP         0x10
#define INV_MPU_BIT_I2C_READ    0x80
#define ACCEL_ACCURACY_SET  0x4000
#define GYRO_ACCURACY_SET   0x2000
#define CPASS_ACCURACY_SET  0x1000
#define FSYNC_SET           0x0800
#define FLIP_PICKUP_SET     0x0400
#define BATCH_MODE_EN       0x0100
#define ACT_RECOG_SET       0x0080
#define SECOND_SEN_OFF_SET  0x0040
#define INV_FSYNC_TEMP_BIT     0x1
#define BANK_SEL_0                      0x00
#define BANK_SEL_1                      0x10
#define BANK_SEL_2                      0x20
#define BANK_SEL_3                      0x30
#define BYTES_PER_SENSOR         6
#define BYTES_FOR_COMPASS        10
#define FIFO_COUNT_BYTE          2
#define HARDWARE_FIFO_SIZE       512
#define FIFO_SIZE                (HARDWARE_FIFO_SIZE * 7 / 8)
#define POWER_UP_TIME            100
#define REG_UP_TIME_USEC         100
#define DMP_RESET_TIME           20
#define GYRO_ENGINE_UP_TIME      50
#define MPU_MEM_BANK_SIZE        256
#define IIO_BUFFER_BYTES         8
#define HEADERED_NORMAL_BYTES    8
#define HEADERED_Q_BYTES         16
#define LEFT_OVER_BYTES          128
#define BASE_SAMPLE_RATE         1000
#define DRY_RUN_TIME             50
#ifdef BIAS_CONFIDENCE_HIGH
#define DEFAULT_ACCURACY         3
#else
#define DEFAULT_ACCURACY         1
#endif
#define MPU_DEFAULT_DMP_FREQ     200
#define PEDOMETER_FREQ           (MPU_DEFAULT_DMP_FREQ >> 2)
#ifdef MEMS_20609
#define MPU_INIT_SENSOR_RATE     5
#endif
#define MIN_MST_ODR_CONFIG       4
#define MAX_MST_ODR_CONFIG       5
#define MAX_MST_NON_COMPASS_ODR_CONFIG 7
#define THREE_AXES               3
#define NINE_ELEM                (THREE_AXES * THREE_AXES)
#define MPU_TEMP_SHIFT           16
#define DMP_DIVIDER              (BASE_SAMPLE_RATE / MPU_DEFAULT_DMP_FREQ)
#define MAX_5_BIT_VALUE          0x1F
#define BAD_COMPASS_DATA         0x7FFF
#define BAD_CAL_COMPASS_DATA     0x7FFF0000
#define DEFAULT_BATCH_RATE       400
#define DEFAULT_BATCH_TIME    (MSEC_PER_SEC / DEFAULT_BATCH_RATE)
#define NINEQ_DEFAULT_COMPASS_RATE 25
#define DATA_AKM_99_BYTES_DMP  10
#define DATA_AKM_89_BYTES_DMP  9
#define DATA_ALS_BYTES_DMP     8
#define APDS9900_AILTL_REG      0x04
#define BMP280_DIG_T1_LSB_REG                0x88
#define TEMPERATURE_SCALE  3340827L
#define TEMPERATURE_OFFSET 1376256L
#define SECONDARY_INIT_WAIT 100
#define MPU_SOFT_REV_ADDR               0x86
#define MPU_SOFT_REV_MASK               0xf
#define SW_REV_LP_EN_MODE               4
#define AK99XX_SHIFT                    23
#define AK89XX_SHIFT                    22
#define MS_PER_PED_TICKS         18
#define MIN_FIFO_RATE            4
#define MAX_FIFO_RATE            MPU_DEFAULT_DMP_FREQ
#define MAX_DMP_OUTPUT_RATE      MPU_DEFAULT_DMP_FREQ
#define MAX_MPU_MEM              8192
#define MAX_PRS_RATE             281
#define REG_I2C_MST_CTRL        0x24
#define BIT_I2C_MST_P_NSR               0x10
enum inv_filter_e {
	INV_FILTER_256HZ_NOLPF2 = 0,
	INV_FILTER_188HZ,
	INV_FILTER_98HZ,
	INV_FILTER_42HZ,
	INV_FILTER_20HZ,
	INV_FILTER_10HZ,
	INV_FILTER_5HZ,
	INV_FILTER_2100HZ_NOLPF,
	NUM_FILTER
};
#endif
#define MS_PER_PED_TICKS         18
#define MIN_FIFO_RATE            4
#define MAX_FIFO_RATE            MPU_DEFAULT_DMP_FREQ
#define MAX_DMP_OUTPUT_RATE      MPU_DEFAULT_DMP_FREQ
#define MAX_READ_SIZE            128
#define MAX_MPU_MEM              8192
#define MAX_PRS_RATE             281
#define PRESSURE_HDR             0x8000
#define ACCEL_HDR                0x4000
#define ACCEL_ACCURACY_HDR       0x4080
#define GYRO_HDR                 0x2000
#define GYRO_ACCURACY_HDR        0x2080
#define COMPASS_HDR              0x1000
#define COMPASS_HDR_2            0x1800
#define CPASS_ACCURACY_HDR       0x1080
#define ALS_HDR                  0x0800
#define SIXQUAT_HDR              0x0400
#define PEDQUAT_HDR              0x0200
#define STEP_DETECTOR_HDR        0x0100
#define COMPASS_CALIB_HDR        0x0080
#define GYRO_CALIB_HDR           0x0040
#define EMPTY_MARKER             0x0020
#define END_MARKER               0x0010
#define NINEQUAT_HDR             0x0008
#define LPQ_HDR                  0x0004
#define STEP_INDICATOR_MASK      0x000f
#define MPU_INIT_SMD_THLD        1500
#ifdef MEMS_20648
#define MPU_INIT_SENSOR_RATE     5
#endif
#define MPU_INIT_GYRO_SCALE      3
#define MPU_INIT_ACCEL_SCALE     0
#define MPU_INIT_PED_INT_THRESH  2
#define MPU_INIT_PED_STEP_THRESH 6
#define COMPASS_SLAVEADDR_AKM_BASE      0x0C
#define COMPASS_SLAVEADDR_AKM           0x0E
#define BIT(x) ( 1 << x )
#define ENABLE  1
#define DISABLE 0
#define FSYNC_INT   BIT(7)
#define MOTION_INT  BIT(3)
#define PLL_INT     BIT(2)
#define DMP_INT     BIT(1)
#define I2C_INT     BIT(0)
#define CHIP_AWAKE          (0x01)
#define CHIP_LP_ENABLE      (0x02)
enum MEMS_SERIAL_INTERFACE {
    SERIAL_INTERFACE_I2C = 1,
    SERIAL_INTERFACE_SPI,
    SERIAL_INTERFACE_INVALID
};
enum mpu_accel_fs {
    MPU_FS_2G = 0,
    MPU_FS_4G,
    MPU_FS_8G,
    MPU_FS_16G,
    NUM_MPU_AFS
};
enum mpu_gyro_fs {
	MPU_FS_250dps = 0,
    MPU_FS_500dps,
    MPU_FS_1000dps,
    MPU_FS_2000dps,
    NUM_MPU_GFS
};
enum INV_ENGINE {
	ENGINE_GYRO = 0,
	ENGINE_ACCEL,
	ENGINE_I2C,
	ENGINE_NUM_MAX,
};
enum ANDROID_SENSORS {
	ANDROID_SENSOR_META_DATA = 0,
	ANDROID_SENSOR_ACCELEROMETER,
	ANDROID_SENSOR_GEOMAGNETIC_FIELD,
	ANDROID_SENSOR_ORIENTATION,
	ANDROID_SENSOR_GYROSCOPE,
	ANDROID_SENSOR_LIGHT,
	ANDROID_SENSOR_PRESSURE,
	ANDROID_SENSOR_TEMPERATURE,
ANDROID_SENSOR_WAKEUP_PROXIMITY,
	ANDROID_SENSOR_GRAVITY,
	ANDROID_SENSOR_LINEAR_ACCELERATION,
	ANDROID_SENSOR_ROTATION_VECTOR,
	ANDROID_SENSOR_HUMIDITY,
	ANDROID_SENSOR_AMBIENT_TEMPERATURE,
	ANDROID_SENSOR_MAGNETIC_FIELD_UNCALIBRATED,
	ANDROID_SENSOR_GAME_ROTATION_VECTOR,
	ANDROID_SENSOR_GYROSCOPE_UNCALIBRATED,
ANDROID_SENSOR_WAKEUP_SIGNIFICANT_MOTION,
	ANDROID_SENSOR_STEP_DETECTOR,
	ANDROID_SENSOR_STEP_COUNTER,
	ANDROID_SENSOR_GEOMAGNETIC_ROTATION_VECTOR,
	ANDROID_SENSOR_HEART_RATE,
	ANDROID_SENSOR_PROXIMITY,
	ANDROID_SENSOR_WAKEUP_ACCELEROMETER,
	ANDROID_SENSOR_WAKEUP_MAGNETIC_FIELD,
	ANDROID_SENSOR_WAKEUP_ORIENTATION,
	ANDROID_SENSOR_WAKEUP_GYROSCOPE,
	ANDROID_SENSOR_WAKEUP_LIGHT,
	ANDROID_SENSOR_WAKEUP_PRESSURE,
	ANDROID_SENSOR_WAKEUP_GRAVITY,
	ANDROID_SENSOR_WAKEUP_LINEAR_ACCELERATION,
	ANDROID_SENSOR_WAKEUP_ROTATION_VECTOR,
	ANDROID_SENSOR_WAKEUP_RELATIVE_HUMIDITY,
	ANDROID_SENSOR_WAKEUP_AMBIENT_TEMPERATURE,
	ANDROID_SENSOR_WAKEUP_MAGNETIC_FIELD_UNCALIBRATED,
	ANDROID_SENSOR_WAKEUP_GAME_ROTATION_VECTOR,
	ANDROID_SENSOR_WAKEUP_GYROSCOPE_UNCALIBRATED,
	ANDROID_SENSOR_WAKEUP_STEP_DETECTOR,
	ANDROID_SENSOR_WAKEUP_STEP_COUNTER,
	ANDROID_SENSOR_WAKEUP_GEOMAGNETIC_ROTATION_VECTOR,
	ANDROID_SENSOR_WAKEUP_HEART_RATE,
	ANDROID_SENSOR_WAKEUP_TILT_DETECTOR,
	ANDROID_SENSOR_NUM_MAX,
    ANDROID_SENSOR_B2S,
	ANDROID_SENSOR_FLIP_PICKUP,
	ANDROID_SENSOR_ACTIVITY_CLASSIFICATON,
	ANDROID_SENSOR_SCREEN_ROTATION,
	SELF_TEST,
	SETUP,
	GENERAL_SENSORS_MAX
};
enum SENSOR_ACCURACY {
	SENSOR_ACCEL_ACCURACY = 0,
	SENSOR_GYRO_ACCURACY,
	SENSOR_COMPASS_ACCURACY,
	SENSOR_ACCURACY_NUM_MAX,
};
#define min(x,y)    (((x)<(y))?(x):(y))
#define max(x,y)    (((x)>(y))?(x):(y))
#ifdef __cplusplus
}
#endif
