adambujak/FALCON/development/applications/hedwig/include/flight_control.h

#ifndef FLIGHT_CONTROL_H
#define FLIGHT_CONTROL_H

#include "falcon_packet.h"

void flight_control_task_start(void);
void flight_control_setup (void);

void flight_control_set_sensor_data(float *gyro_data, float *accel_data, float *quat_data, float alt_data);
void flight_control_set_command_data(fpc_flight_control_t *control_input);
void flight_control_set_controller_params(uint8_t *data, fp_type_t packetType);
void flight_control_get_outputs(fpr_status_t *status_response);
int flight_control_set_mode(fe_flight_mode_t new_mode);
fe_flight_mode_t flight_control_get_mode(void);
void flight_control_calibrate_sensors(void);


#endif // FLIGHT_CONTROL_H
