adambujak/FALCON/development/applications/hedwig/src/radio.c

#include "radio.h"

#include "bsp.h"
#include "falcon_common.h"
#include "frf.h"
#include "fifo.h"
#include "radio_common.h"

#define RF_RX_BUFFER_SIZE 512
#define RF_TX_BUFFER_SIZE 2048

static uint8_t rx_buffer[RF_RX_BUFFER_SIZE];
static uint8_t tx_buffer[RF_TX_BUFFER_SIZE];

static fifo_t rx_fifo;
static fifo_t tx_fifo;

static uint8_t hedwig_address[RADIO_ADDRESS_LENGTH];
static uint8_t albus_address[RADIO_ADDRESS_LENGTH];

static frf_t radio;

static void rf_spi_transfer(void *context, uint8_t *tx_buf, uint16_t tx_len, uint8_t *rx_buf, uint16_t rx_len)
{
  bsp_rf_transceive(tx_buf, tx_len, rx_buf, rx_len);
}

static inline void rf_isr(void)
{
  frf_isr(&radio);
}

static void rf_event_callback(frf_event_t event)
{
  switch(event) {
    case FRF_EVENT_TX_FAILED:
      LOG_DEBUG("RF TX FAILED\r\n");
      break;
    case FRF_EVENT_TX_SUCCESS:
      LOG_DEBUG("RF TX SUCCESS\r\n");
      break;
    case FRF_EVENT_RX:
    {
      uint8_t temp[FRF_PACKET_SIZE];
      frf_getPacket(&radio, temp);
      fifo_push(&rx_fifo, temp, FRF_PACKET_SIZE);
      LOG_DEBUG("RF RX Event\r\n");
      break;
    }
  }
}

uint32_t radio_status_get(void)
{
  return frf_getStatus(&radio);
}

uint32_t radio_data_send(uint8_t *source, uint32_t length)
{
  if (length > RF_TX_BUFFER_SIZE) {
    return 0;
  }

  fifo_push(&tx_fifo, source, length);
  return length;
}

uint32_t radio_data_get(uint8_t *dest, uint32_t length)
{
  return fifo_pop(&rx_fifo, dest, length);
}

uint32_t radio_rx_cnt_get(void)
{
  return rx_fifo.bytes_available;
}

void radio_reset(void)
{
  frf_start(&radio, 2, FRF_PACKET_SIZE, albus_address, hedwig_address);
}

void radio_init(void)
{
  radio_get_hedwig_address(hedwig_address);
  radio_get_albus_address(albus_address);

  fifo_init(&rx_fifo, rx_buffer, RF_RX_BUFFER_SIZE);
  fifo_init(&tx_fifo, tx_buffer, RF_TX_BUFFER_SIZE);

  FLN_ERR_CHECK(bsp_rf_init(rf_isr));

  /* RF Module Init */
  frf_config_t config = {
    .transferFunc = rf_spi_transfer,
    .role = FRF_DEVICE_ROLE_RX,
    .spiCtx = NULL,
    .setCS = bsp_rf_cs_set,
    .setCE = bsp_rf_ce_set,
    .delay = rtos_delay_ms,
    .eventCallback = rf_event_callback
  };

  frf_init(&radio, &config);
  frf_start(&radio, 2, FRF_PACKET_SIZE, hedwig_address, albus_address);
}

void radio_process(void)
{
  frf_process(&radio);

  if (!frf_isSending(&radio)) {
    uint8_t temp[FRF_PACKET_SIZE];
    if (fifo_pop(&tx_fifo, temp, FRF_PACKET_SIZE) == FRF_PACKET_SIZE) {
      frf_sendPacket(&radio, temp);
    }
  }
}
