adambujak/FALCON/dependencies/invensense/eMD_ICM20648_20948_v1_3/emd-ICM20648-20948-stm32f4xx-1.3.0.rc1/emd-ICM20648-20948-stm32f4xx-1.3.0.rc1/embedded-motion-driver/DeviceSupport/src/board-st_discovery.c

#include "stm32f4xx.h"
#include "stm32f4xx_usart.h" 
#include "stm32f4xx_rcc.h"
#include "i2c.h"
#include "uart.h"
#include "gpio.h"
#include "board-st_discovery.h"

#define TICK_FREQ (1000u)

volatile uint32_t g_ul_ms_ticks=0;
static volatile uint32_t TimingDelay=0;
unsigned long idle_time=0;
extern uint32_t SystemCoreClock; //168000000=168Mhz (original value)

void board_init() 
{
	SystemCoreClockUpdate();                               // Update the system clock variable (might not have been set before)
                                                           // With this call, the core clock gets set to 56MHz
    
	if (SysTick_Config (SystemCoreClock / TICK_FREQ)) {     // Setup SysTick Timer for 1 msec interrupts
		while (1);                                          // Handle Error
	}	
	
	Set_I2C_Retry(5);
  
	/* Enable PWR APB1 Clock */
	RCC_APB1PeriphClockCmd(RCC_APB1Periph_PWR, ENABLE);

	/* Allow access to Backup */
	PWR_BackupAccessCmd(ENABLE);

	/* Reset RTC Domain */
	RCC_BackupResetCmd(ENABLE);
	RCC_BackupResetCmd(DISABLE);
 
	//Configure Interrupts
	GPIO_Config();  

	// Configure I2C
	I2cMaster_Init(); 

	// Configure UART
	USART_Config(); 
        USART_Config6();
}

void mdelay(unsigned long nTime)
{
	TimingDelay = nTime;
	while(TimingDelay != 0);
}

int get_tick_count(unsigned long *count)
{
        count[0] = g_ul_ms_ticks;
	return 0;
}

void TimingDelay_Decrement(void)
{
	if (TimingDelay != 0x00)
		TimingDelay--;
}

void TimeStamp_Increment(void)
{
	g_ul_ms_ticks++;
}

void SysTick_Handler(void)
{
  	TimingDelay_Decrement();
    TimeStamp_Increment();
}
