adambujak/FALCON/development/drivers/ICM20948/driver/inv_mems_mpu_selftest_20609.c

/*
* ________________________________________________________________________________________________________
* Copyright © 2016-2016 InvenSense Inc. Portions Copyright © 2014-2015 Movea. All rights reserved.
* This software, related documentation and any modifications thereto (collectively “Software”) is subject
* to InvenSense and its licensors' intellectual property rights under U.S. and international copyright and
* other intellectual property rights laws.
* InvenSense and its licensors retain all intellectual property and proprietary rights in and to the Software
* and any use, reproduction, disclosure or distribution of the Software without an express license
* agreement from InvenSense is strictly prohibited.
* ________________________________________________________________________________________________________
*/
#ifdef MEMS_20609

#include "driver/inv_mems_mpu_selftest.h"

#include "driver/inv_mems_defines.h"
#include "driver/inv_mems_base_driver.h"
#include "common/inv_mems_drv_hook.h"
#include "driver/inv_mems_transport.h"

////
extern int a_average[3];
extern int g_average[3];

/* register settings */
#define DEF_SELFTEST_GYRO_SENS          (32768 / 250)
/* wait time before collecting data */
#define MAX_PACKETS                     20
#define SELFTEST_WAIT_TIME              (MAX_PACKETS * 10)
#define DEF_ST_STABLE_TIME              20
#define DEF_GYRO_SCALE                  131
#define DEF_ST_PRECISION                1000
#define DEF_ST_ACCEL_FS_MG              2000UL
#define DEF_ST_SCALE                    32768
#define DEF_ST_TRY_TIMES                2
#define DEF_ST_ACCEL_RESULT_SHIFT       1
#define DEF_ST_SAMPLES                  200

#define DEF_ACCEL_ST_SHIFT_DELTA_MIN    500
#define DEF_ACCEL_ST_SHIFT_DELTA_MAX    1500
#define DEF_GYRO_CT_SHIFT_DELTA         500

#define SENSOR_UP_TIME	30
#define REG_UP_TIME		2
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
