adambujak/FALCON/(commit log)

2020-03-31 Added testing motor mount CAD file
    [motorholder.ipt]
2020-03-31 Added driver libs to eclipse project
2020-03-31 Copied i2c sample application into main.c
2020-04-01 i2c read/write working
2020-04-01 Added TI MSP SDK to repository
    [build.cfg]
2020-04-03 Started working on I2C HAL
2020-04-03 More work on i2c
    [motorholder-nocurvature.ipt]
2020-04-03 started i2c abstraction
    [Part2.stl, motorconnector.ipt]
2020-04-04 Blocking i2c read/write functions complete
2020-04-04 Implemented master i2c driver -Blocking read and write working.
    [Part2.stl, motorconnector.ipt, motorholder-nocurvature.ipt]
2020-04-05 Refactored i2c driver
2020-04-05 Attempted to implement non-blocking read - facing clock stretching issues
    [main.c]
2020-04-08 Refactored IO system hal - Renamed i2c_master to fi2c_hal - Renamed fiodt to fio_common - Added mode types to bsp - Added base for future peripheral support
2020-04-08 Implemented library layer for FIOM - Fixed bug where i2c layer was calling incorrect callback - Added isModuleInit function to fio_hal
    [fi2c_hal.c, fio_hal.c, fio_hal.h, main.c]
2020-04-08 Added write functionality to i2c hal
2020-04-08 Changed FIO error naming
    [fio_common.h, fio_hal.c, main.c]
2020-05-22 Added nordic sdk
    [config.txt]
2020-06-24 Added TI motor refereneces
2020-07-28 Updating dependency locations and remove arm compiler from repo (#6)
    * Move dependencies to dependencies folder
    * Update gcc dependency scheme
    [build.cfg, config.txt]
2020-07-28 Added nRF24L01 driver, library, and test apps
    * Add nrf24l01 driver
    * Add frf library
    * Add rf test applications
    * Change author comment
2020-07-29 Reformat frf library
    * Reformat frf library
    - Include power state tracking to avoid unnecessary writes
    - Add blocking/nonBlocking read/write functions
    - Refactor code
    * Update device_com file to use new frf features
    [device_com.c]
2020-08-03 Fix RF issues (not receiving) (#9)
    * Changed RX app start log message
    * Refactor library to actually work, and track power states
    * Updated device com layer to follow updated library
    * Change tx string
    [device_com.c, main.c]
2020-10-03 Add freertos blinky example for STM32F412
2020-10-03 Made separate file for led task
2020-10-05 add bsp for stm32 dev board
2020-10-05 Change error checking for rtos calls
    [main.c]
2020-10-05 Add better error handling
    [main.c]
2020-10-06 gitignore update and cleanup (#12)
    * Remove unused function prototype
    * Add tags to gitignore
2020-10-17 Add sensors i2c
2020-10-17 Fix function declarations to match functions defs
    [bsp.h]
2020-10-21 Add motor control with PWM (#18)
    * Add motor control with PWM
    * Change pins
    * Fix assert
    [bsp.c, bsp.h, main.c, motors.c, motors.h]
2020-11-04 added ICM20948 motion driver dependencies
2020-11-11 Add V1 PCB and Schematic (#24)
    * Add custom spi functions to HAL
    * Add spi to v2 app and add frf
    * Add pcb and schematic
    * updated schematic and pcb
    * change top plane to gnd and add breakout
    * newest version - done
    * Pcb overhall - put imu in middle, made board square
    * Add logo to that pcb
    * latest board - square, logo
    * Added pics, pdf, fixed silkscreen, and added more vias
    * Fix major issues in hardware
    [hedwig.brd, hedwig.sch]
2020-11-11 Add support for new board and some other fixes (#23)
    * - Add support for new board
    - Fix FreeRTOS delay bug (if delayed before scheduler starts, hard fault)
    - Code cleanup in bsp
    * add jlink serial id
    [bsp.c, bsp.h, leds.c, main.c]
2020-11-13 Fix FRF library, and add to stm (#26)
    Add spi to v2 app and add frf
    Sending data
    working with restart
    sending frf
    Sending data
    Change stm pins to match custom board
    getting interrupt from rx
    fix max_rt bug
    interrupt based read
    Move rx clear rxPowerUp
    Sending and receiving data with interrupts
    Interrupt based tx/rx - remove old polling code and unused public functions
    Remove packet drop in max_Rt
    Add power state support
    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
    [bsp.c, bsp.h, device_com.c, device_com.h, leds.c, main.c, nRF24L01.c]
2020-11-13 Add support for LED driver on new board (#25)
    * LED ON
    * working
    * Blinking led
    * added set color function to header
    * Abstract timer handler
2020-11-19 added motor init function from testing on hardware
2020-12-02 Update pin def for radio for custom board
2020-12-17 Add devin sensor code
    * added driver dependency files
    * added ICM interface files
    * added working fimu library files
    * updated makefile
    * added MPL driver
    * added sensors task
    * removed WError for now
    * general setup for sensors task
    * sensors task and barometer library setup
    * updated sensors task for different rate barometer readings
    * minor fixes to barometer driver
    * improved fbaro calibration function
    * changed startup sequence
    * changes for new board
    [MPL3115A2.c, MPL3115A2.h, bsp.c, bsp.h]
2020-12-17 schematic and pcb update
    [bom.csv, hedwig.brd, hedwig.sch]
2020-12-18 fixed uart
2020-12-22 Reduce motor delay time, and increase sensor task priority
2020-12-30 fix irq naming for imu
    [bsp.c]
2021-01-30 RF packets sending back and forth feature (#28)
    * add assert to both hedwig and albus
    * add albus - stm32
    deleted eclipse
    Add frf process so it'll work
    * add radio common to makefile
    * fix disco board issue in makefile
    * implement radio common into device com
    * both sending and receiving
    [albus.h, device_com.c, device_com.h, main.c]
2021-02-01 Schematic Update (#29)
    - Fix USB C port reversablilty issue
    Board Update
    - Fix USB C port reversablilty issue
    BOM Update
    - Fix incorrect logic level shift FET
    - Fix multiple entries for same parts
    [bom.csv, hedwig.brd, hedwig.sch]
2021-03-13 Merge grinbuf library and test infrastructure (#30)
    * add grinbuf
    * add testing framework
2021-03-14 General fixes to hedwig and albus (#32)
    * change VDISCO to DISCO
    * Add common defines
    * increase stack and heap size for albus
    * Change FreeRTOS OS started scheme
    [albus.h, bsp.h, hedwig.h, main.c]
2021-03-14 Sending falcon packets back and forth (#33)
    * changes to frf
    * albus device com changes
    * hedwig changes to receive falcon packets
2021-03-14 Updated sensor development with flight control (#34)
    * literally everything for all sensors i guess
    restore changes
    delete .cproject
    delete .project
    * fix makefile board define
    * fix makefile includes
    [bsp.c, motors.c, motors.h, sensors.c, sensors.h]
2021-03-14 changed flightController motors to normal output variable
2021-03-14 sensors task running alongside device com
2021-03-14 temp sensors.c commit
2021-03-14 fix for imu hook file using taskDelay
    [inv_mems_drv_hook.c]
2021-03-14 implemented flight control code in its own task, passing sensor data to it using mutex, added task notification to imu int
2021-03-15 move thread creation into respective modules
2021-04-02 big rewrite (#40)
    * start adding cornelius
    * update python fp to return encoded bytearray
    * monitor scrolling
    * was working before but not receiving uart now
    * receiving packets - todo figure out python exit
    * idk
    * cornelius test file
    * new albus has uart
    * misc fixes
    * add power of two assert
    * nvic changes, blocking logger
    * albus rewrite
    * wrap up system time
    * add led toggle to error handler and start device com task
    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
    [albus.h, board.h, bsp.c, bsp.h, cornelius.py, device_com.c, device_com.h, flight_control.c]
2021-04-03 fix rf on albus (#41)
    fix rf on albus,
    add hal back
    [albus.h, board.h, device_com.c, gpio.c, main.c, radio.c, radio.h, spi.c]
2021-04-03 change system time variable names (#42)
    move system time to common
    fix board.h
    [board.h, system_time.c, system_time.h]
2021-04-05 Radios talking reliably back and forth with acks (#43)
    * speed up write time
    * working with dynamic
    * sending ack with payload
    * change delay from us
    * remove unnecessary irq clear
    * remove fifo
    * remove frf mutex
    * decouple frf_getPacket
    * lower device com priority
    * move radio to radio module
    * remove delay in device com | general cleanup
    * add public radio functions
    * move decoder into device com
    * move sending and getting into device com
    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
2021-04-10 General cleanup and device com improvment (#45)
    * change clang-format
    * add ozone files to gitignore
    * workign
    * increase stack and heap to try and avoid hard fault
    * change log levels
    * fix warnings in ICM driver
    * fix warning in fimu
    * change radio functions
    * change system time timer
    * change priorities and abstract stack sizes
    * radio naming and logic changes
    * general cleanup
    * radio naming changes
    * run formatter
    [board.h, device_com.c, flight_control.c, hedwig.h, inv_mems_base_driver.c, inv_mems_mpu_selftest.c, inv_mems_transport.c]
2021-04-11 data from device com into flight control using mutex
2021-04-11 got software timer working with task notification
2021-04-11 post rebase minor fixes
    [flight_control.c]
2021-04-11 turned on sensors and FC in main, rename in FC xTaskCreate
2021-04-11 switched vTaskDelay for rtos_delay_ms in sensor libraries
2021-04-11 fixed barometer problem, device com sensors and FC working at once
    [flight_control.c, hedwig.h, sensors.c]
2021-04-11 remove commented out code form device com.h
2021-04-11 update clang_format switch case indent
2021-04-11 add tx queing to device com
2021-04-11 device com sending nicely
2021-04-11 fixup hedwig device com
    [device_com.c]
2021-04-11 Add packet queuing to hedwig (#48)
    * add packet queuing to hedwig
    * change timer and add header
2021-04-12 created motors emergency stop and added to all error handlers
    [bsp.c, device_com.c, main.c, motors.c, motors.h]
2021-04-12 changed to motors_off call in FC
2021-04-12 Finally sending data through system (#50)
    * add new packet for testing
    ''
    * add sending test response to device com
    * disable logging on albus
    * disable gui, and send test query
2021-04-12 error handler LOG statement
    [main.c]
2021-04-16 Sending data back and forth from cornelius (#54)
    * current debug session
    * change time
    * revert albus changes
    * add decoder
    * add to dict method
    * add input to cornelius.py
    * add radio stats packet
    * add radio stats getting and cookie cnt incrementing and vtasksuspedall in errhandler
    * remove vscode files
    * fix falcon packet path
    * delete test files
    * fix (#55)
    [board.h, cornelius.py, device_com.c, main.c, radio.c, radio.h]
2021-04-16 add stm32cubide folder to gitignore
2021-04-18 remove unused led code
2021-04-18 changing flight control mode from cornelius (#58)
    * changing flight control mode from cornelius
    * calibration command working
    * changes to PR per adams comments
    * modified calib enum
2021-04-20 adam fix this loser
    [cornelius.py, device_com.c, flight_control.c, flight_control.h]
2021-04-20 Change device com - Always send multiple of 32 to radio - Add status process
2021-04-23 setting up for rotor stand test
2021-04-27 minor fixes to sensor libs
2021-04-27 added bias to flight control system and sensor code
2021-05-04 tunable parameters updated, gyro and ypr measurement messed up when motors on
2021-05-07 added PID param tuning commands, falcon was hovering somewhat stably on test stand before disaster struck
2021-05-18 added method to spin up motors
2021-05-18 switched to Game rotation vector and it seems better
2021-06-03 made the altitude submit button work properly
